sky4walk/BrausteuerungV1/Hardware/ArduinoUNO_Rev3_ProtoShield_Steckplatine.jpg

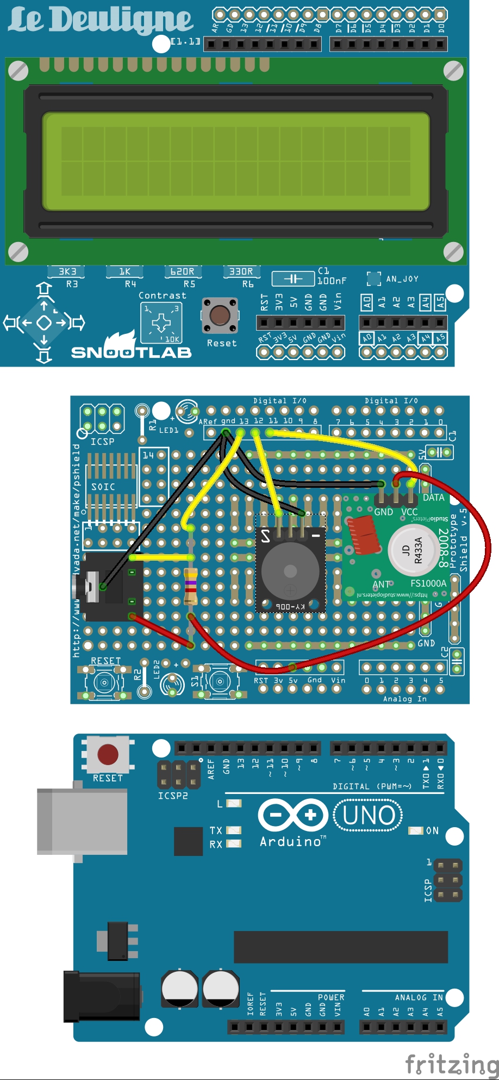
Hardware/ArduinoUNO_Rev3_ProtoShield_Steckplatine.jpg
