sky4walk/BrausteuerungV1/Hardware/KiCad_ArduinoUnoR3ProtoShield/KiCad_ArduinoUnoR3ProtoShield-3D.jpg

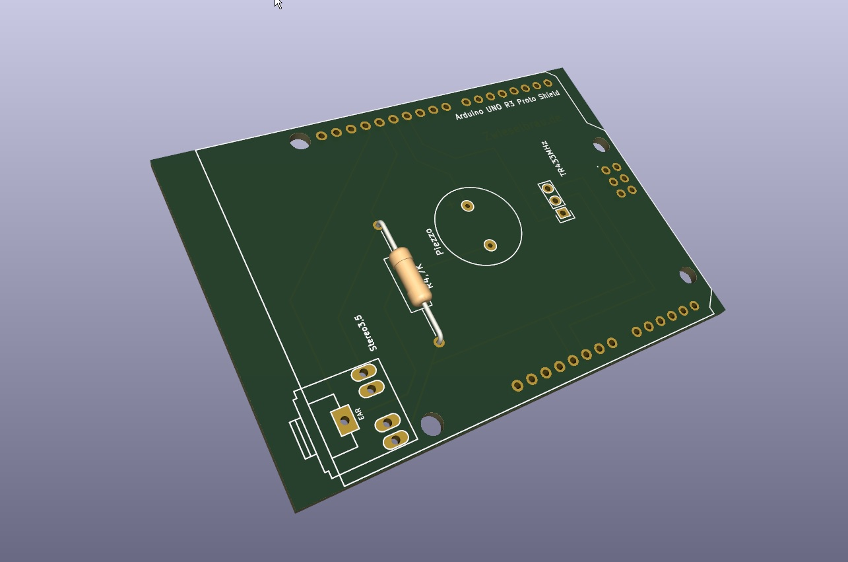
Hardware/KiCad_ArduinoUnoR3ProtoShield/KiCad_ArduinoUnoR3ProtoShield-3D.jpg
