sky4walk/BrausteuerungV1/README.md

# BrausteuerungV1
brausteuerung@AndreBetz.de

Zwieselbrau.de
