sky4walk/BrausteuerungV1/Software/Brausteuerung2/Readme.txt

 sudo apt install avrdude
 git clone git@github.com:sky4walk/BrausteuerungV1.git
./arduino-ide_2.3.8_Linux_64bit.AppImage --no-sandbox
