sky4walk/BrausteuerungV1/Blende/arduino_uno_lcd_orig-bottom.png

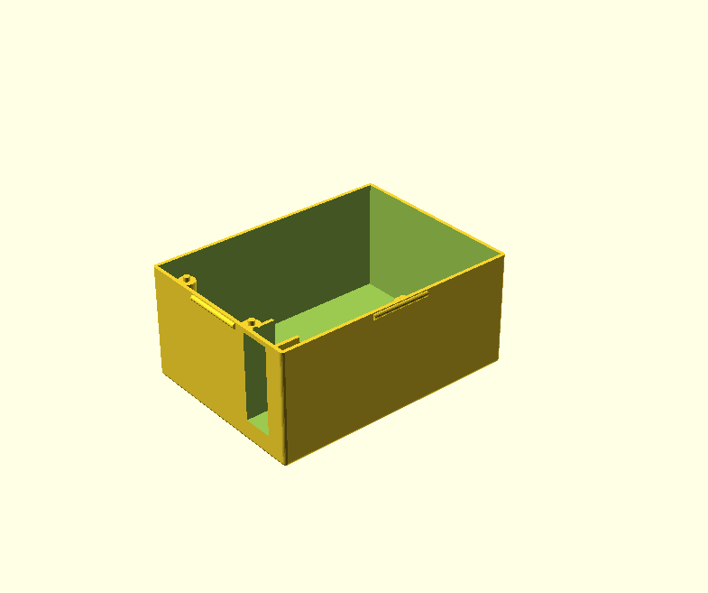
Blende/arduino_uno_lcd_orig-bottom.png
