sky4walk/BrausteuerungV1/Blende/arduino_uno_lcd_orig-top.png

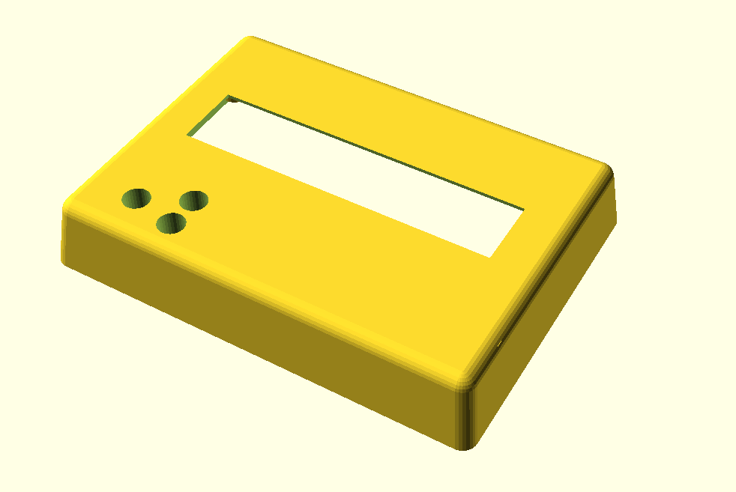
Blende/arduino_uno_lcd_orig-top.png
