sky4walk/BrausteuerungV1/Dokumente/BierbrauUtilitiesZeichnung.jpeg

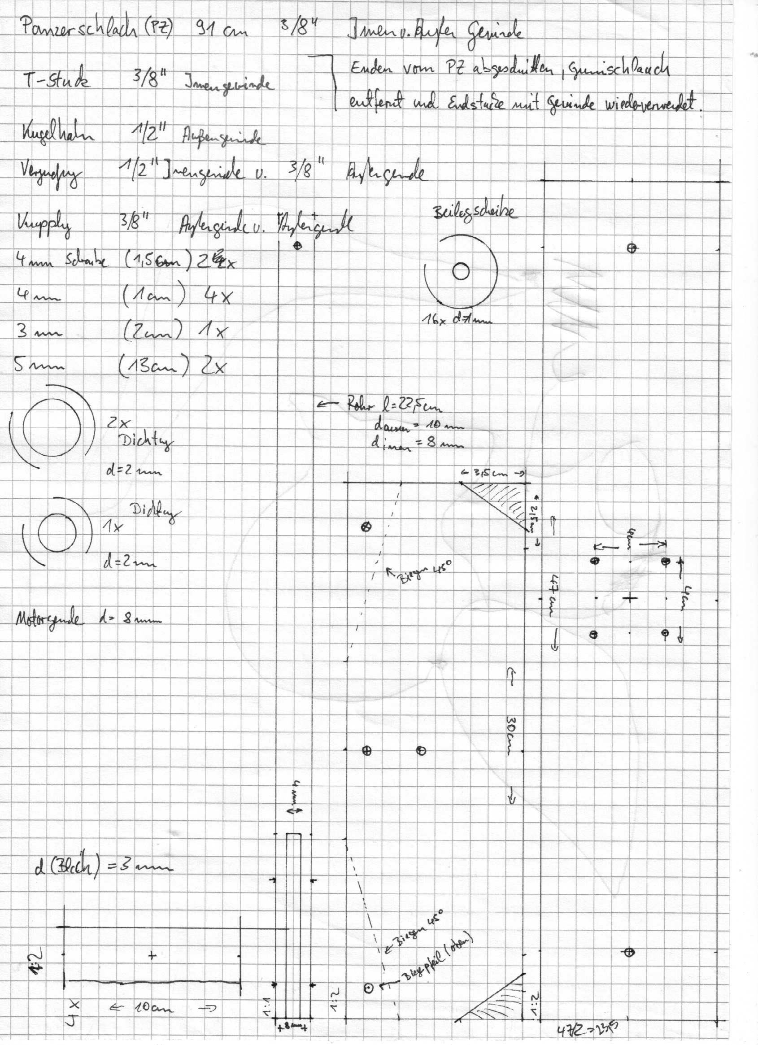
Dokumente/BierbrauUtilitiesZeichnung.jpeg
