sky4walk/BrausteuerungV1/Hardware/Arduino433MHzTransmitter.jpg

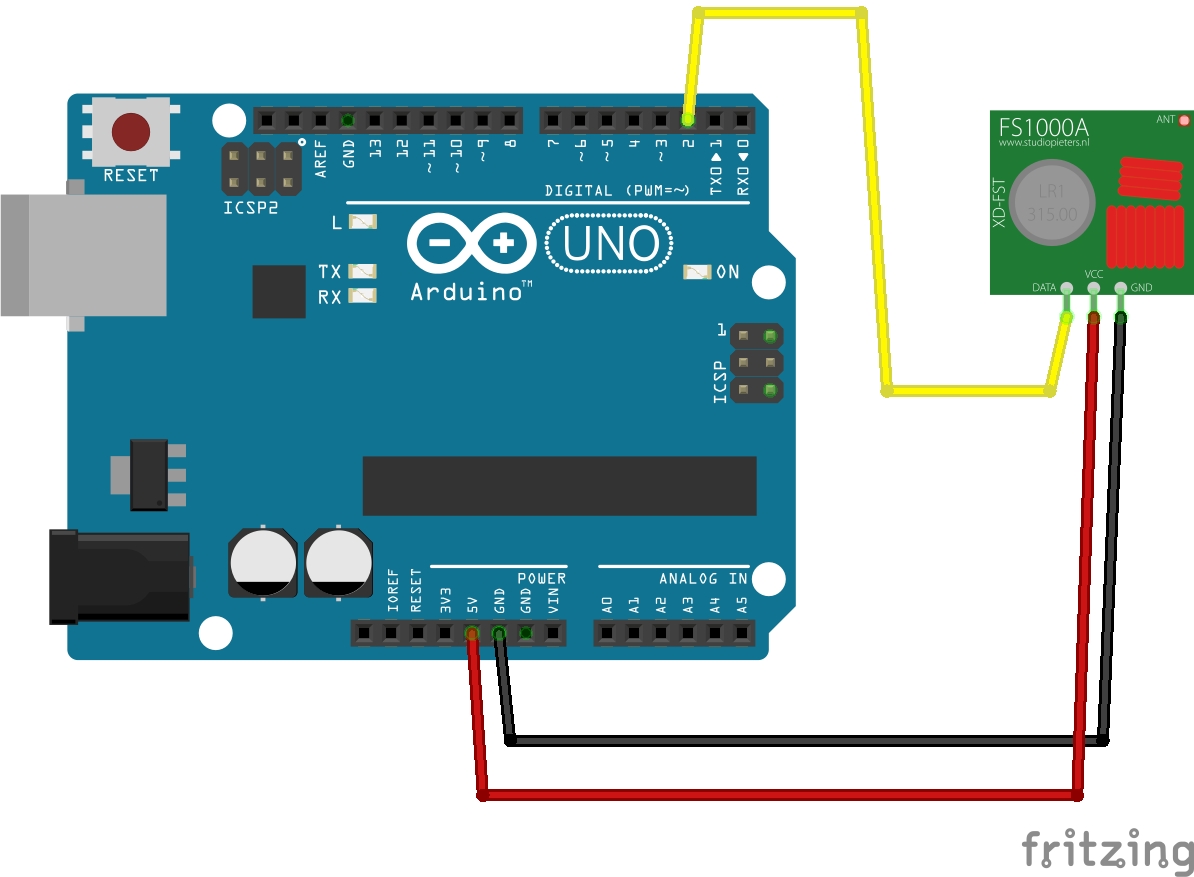
Hardware/Arduino433MHzTransmitter.jpg
