sky4walk/BrausteuerungV1/Hardware/ArduinoBoard_Steckplatine.jpg

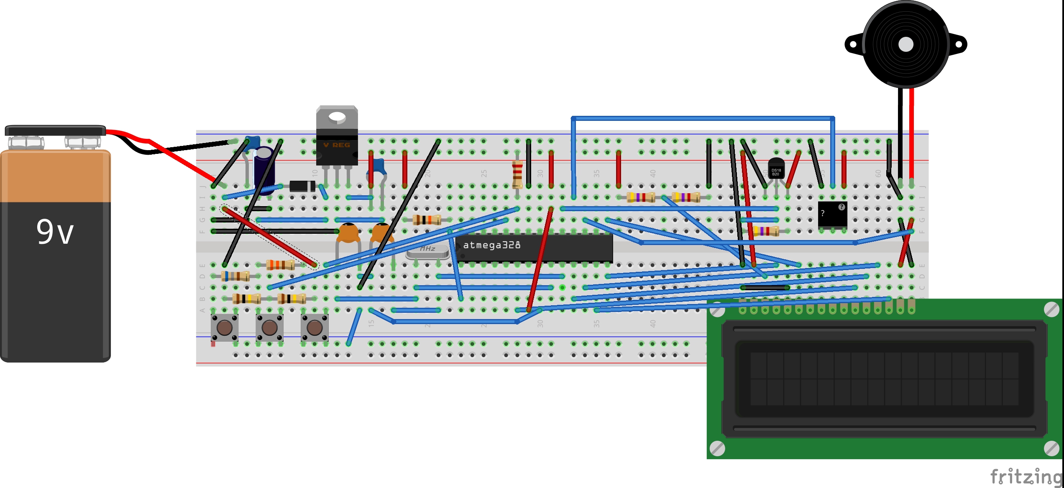
Hardware/ArduinoBoard_Steckplatine.jpg
