sky4walk/BrausteuerungV1/Hardware/ArduinoReceiver433.jpg

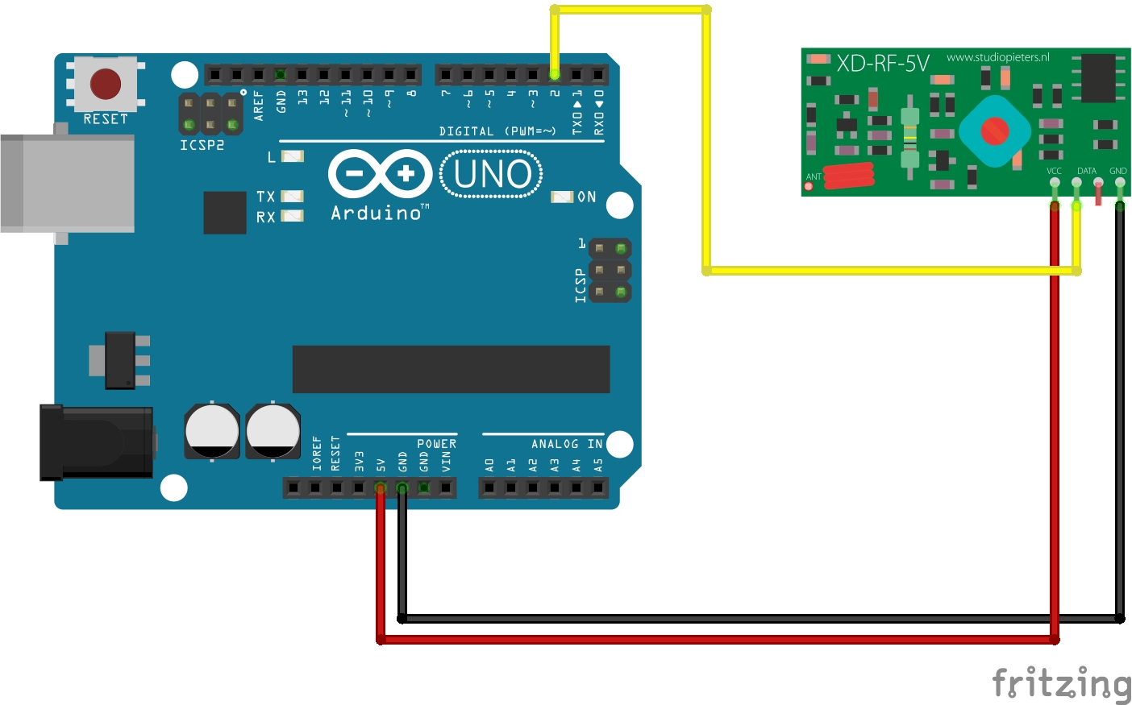
Hardware/ArduinoReceiver433.jpg
