sky4walk/BrausteuerungV1/Blende/arduino_uno_lcd_orig-bottom.stl

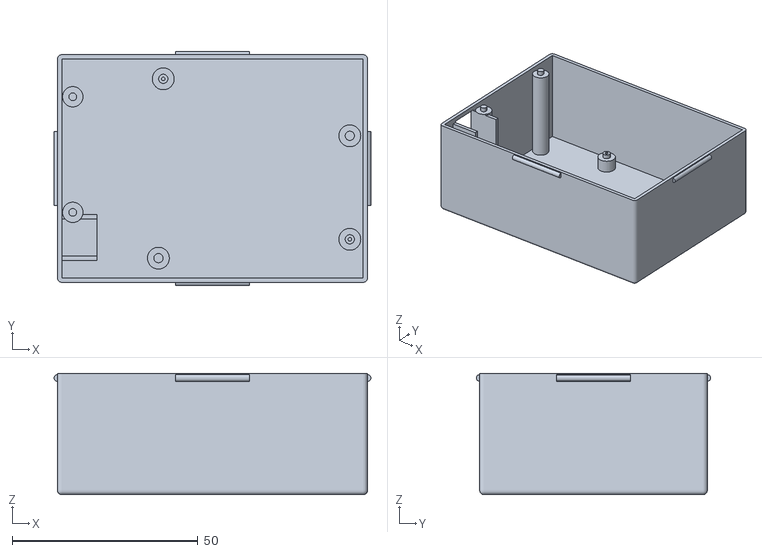
[picture p11: CAD file, 2022-05-28]
Blende/arduino_uno_lcd_orig-bottom.stl
85.3 x 63.1 x 32.6
