sky4walk/BrausteuerungV1/Blende/arduino_uno_lcd_orig-buttons.stl

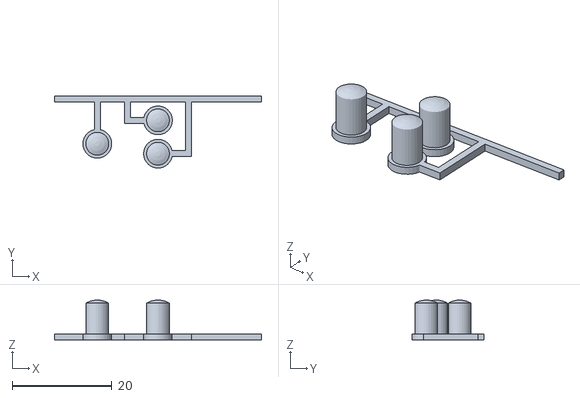
[picture p12: CAD file, 2022-04-10]
Blende/arduino_uno_lcd_orig-buttons.stl
41.6 x 14.5 x 7.99
