sky4walk/BrausteuerungV1/Blende/arduino_uno_lcd_orig-top.stl

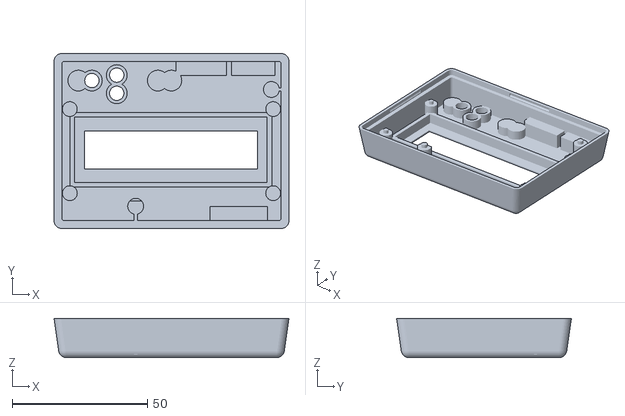
[picture p13: CAD file, 2022-04-10]
Blende/arduino_uno_lcd_orig-top.stl
86.9 x 64.7 x 14.5
