sky4walk/BrausteuerungV1/(list of files, cad)

Other CAD files:
Blende/font.dxf
