sky4walk/BrausteuerungV1/Hardware/KiCad_ArduinoUnoR3ProtoShield/KiCad_ArduinoUnoR3ProtoShield.pdf

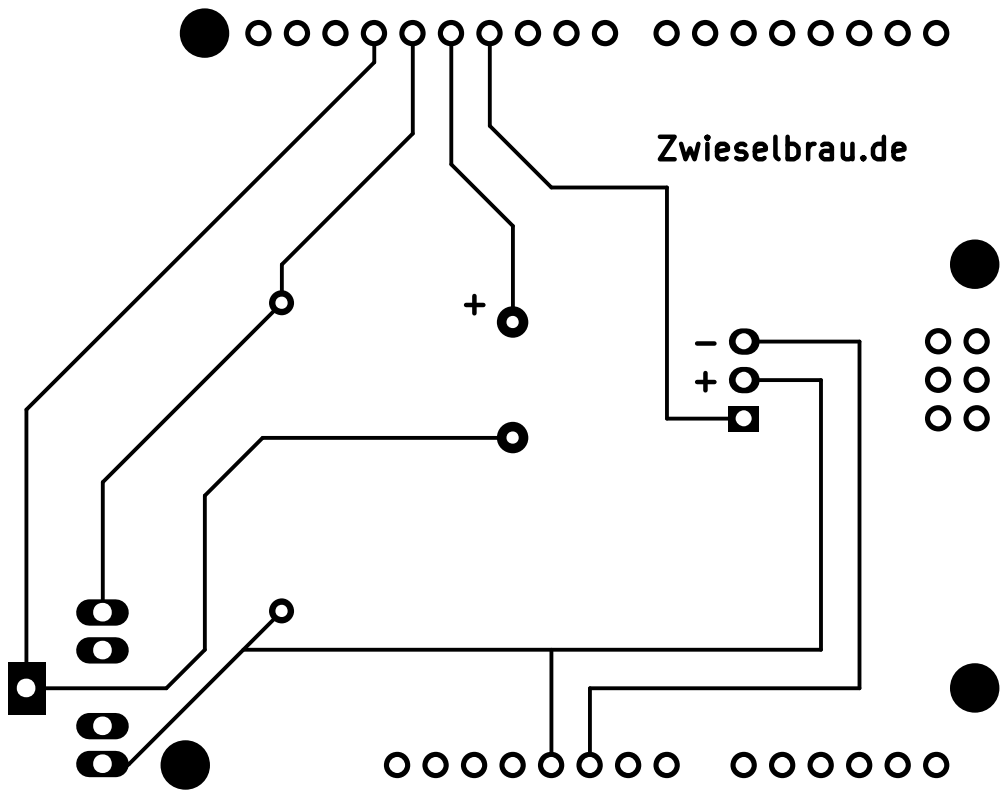
[picture p21: page 1]
