sky4walk/BrausteuerungV1/(list of files, drawings)

Other design files:
Hardware/Arduino433MHzTransmitter.fzz
Hardware/ArduinoBoard.fzz
Hardware/ArduinoReceiver433.fzz
Hardware/ArduinoUNO_Rev3_ProtoShield.fzz
