sky4walk/BrausteuerungV1/(commit log)

2016-02-20 BrausteuerungV1 complete
    [ArduinoBoard.fzz, LCD_Keypad_Shield_Case.scad, WEEE.scad, font.dxf]
2016-04-07 added beerlicence
    [LCD_Keypad_Shield_Case.scad]
2022-03-14 new easier Hardware design
    [ArduinoUNO_Rev3_ProtoShield.fzz]
2022-03-14 added prototype shield
    [ArduinoUNO_Rev3_ProtoShield.fzz]
2022-03-21 Brausteuerung V1.1.
    [ArduinoUNO_Rev3_ProtoShield.fzz]
2022-03-21 wrog wireing
    [ArduinoUNO_Rev3_ProtoShield.fzz]
2022-03-29 started temp regulator
2022-03-31 added case but not changed
    [arduino_uno_lcd_orig.scad]
2022-04-10 case top
    [arduino_uno_lcd_orig-buttons.stl, arduino_uno_lcd_orig-top.stl, arduino_uno_lcd_orig.scad]
2022-04-13 created gcode for cover
    [arduino_uno_lcd_orig-bottom.stl, arduino_uno_lcd_orig.scad]
2022-04-14 bottom 1mm higher
    [arduino_uno_lcd_orig-bottom.stl, arduino_uno_lcd_orig.scad]
2022-04-14 start pcb design
    [KiCad_ArduinoUnoR3ProtoShield.kicad_pcb, KiCad_ArduinoUnoR3ProtoShield.kicad_sch]
2022-04-14 added all parts
    [KiCad_ArduinoUnoR3ProtoShield.kicad_pcb]
2022-04-15 gerber files in zip created
    [KiCad_ArduinoUnoR3ProtoShield-B_Cu.gbr, KiCad_ArduinoUnoR3ProtoShield-B_Mask.gbr, KiCad_ArduinoUnoR3ProtoShield-B_Paste.gbr, KiCad_ArduinoUnoR3ProtoShield-B_Silkscreen.gbr, KiCad_ArduinoUnoR3ProtoShield-Edge_Cuts.gbr, KiCad_ArduinoUnoR3ProtoShield-F_Cu.gbr, KiCad_ArduinoUnoR3ProtoShield-F_Mask.gbr, KiCad_ArduinoUnoR3ProtoShield-F_Paste.gbr]
2022-04-25 better view
    [ArduinoUNO_Rev3_ProtoShield.fzz]
2022-05-23 changed delta PID values
2022-05-25 better case bottom
    [arduino_uno_lcd_orig-bottom.stl, arduino_uno_lcd_orig.scad]
2022-05-25 case complete ANetA6 3D Print
2022-05-28 bottom case 13mm hight
    [arduino_uno_lcd_orig-bottom.stl, arduino_uno_lcd_orig.scad]
2022-06-16 start timer after reading temp changed
2022-07-29 resync LCD when garbage is shown with reconnecting sensor
2026-03-18 433MHz receiver circuit schematic
    [ArduinoReceiver433.fzz]
2026-03-18 arduino 433MHz transmitter
    [Arduino433MHzTransmitter.fzz]
